bvksound/UPL_AudioAnalyzer/KEYBOARD/BOM/BOM KeyBoard.xlsx

Part | Supplier | Amount | Unit price | Total (Unit Price) | Description
N/A | JLCPCB | 1 |  | 0 | PCB
evq-q2b01w (https://be.farnell.com/panasonic/evq-q2b01w/switch-tactile-spst-20ma-15vdc/dp/2284612?ost=evq-q2b01w) | RSComponents | 50 | 0.316 | 15.8 | Button
538-52044-3445 (https://www.mouser.be/ProductDetail/538-52044-3445) | Mouser | 1 | 2.84 | 2.84 | 34Pin FPC Connector
FPC Cable 34Pin (https://nl.aliexpress.com/item/4000218028794.html?spm=a2g0s.9042311.0.0.27424c4dXkaReW) | Aliexpress | 1 | 2.91 | 2.91 | 34Pin FPC Cable pitch 1.25mm
Generic | Farnell | 6 | 0.05 | 0.3 | LED 1206
 |  |  | Euro | 21.85
