bvksound/UPL_AudioAnalyzer/KEYBOARD/CAD/Buttons.dxf

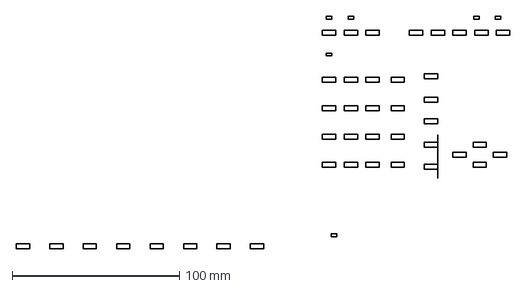
[picture p1: CAD file, 2020-04-19]
KEYBOARD/CAD/Buttons.dxf
295.0 x 138.8 mm
