bvksound/UPL_AudioAnalyzer/KEYBOARD/CAD/Outline.dxf

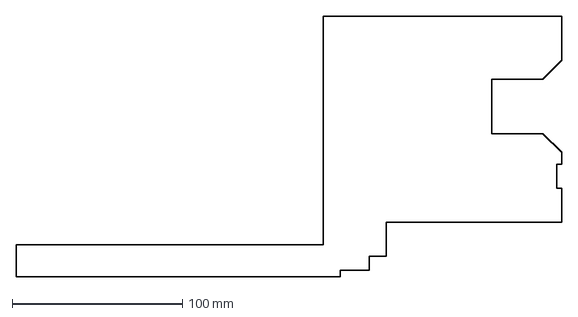
[picture p2: CAD file, 2020-04-19]
KEYBOARD/CAD/Outline.dxf
320.0 x 153.0 mm
