bvksound/UPL_AudioAnalyzer/KEYBOARD/CAD/Holes.dxf

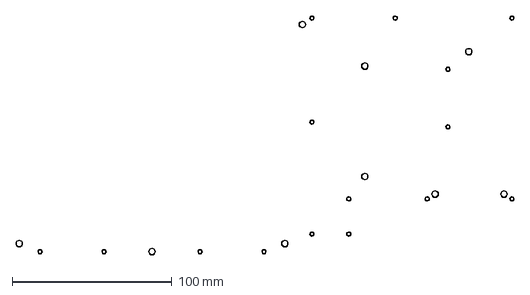
[picture p3: CAD file, 2020-04-19]
KEYBOARD/CAD/Holes.dxf
311.2 x 149.2 mm
