bvksound/UPL_AudioAnalyzer/(list of files, cad)

Other CAD files:
ISA INTERCONNECT/CAD/ISA Interconnect v3.dxf
KEYBOARD/CAD/R&S UPL KeyBoard BackPanel.f3d
