bvksound/UPL_AudioAnalyzer/KEYBOARD/PCB/SMD Buttons/UPL_Keyboard_Schematic.pdf

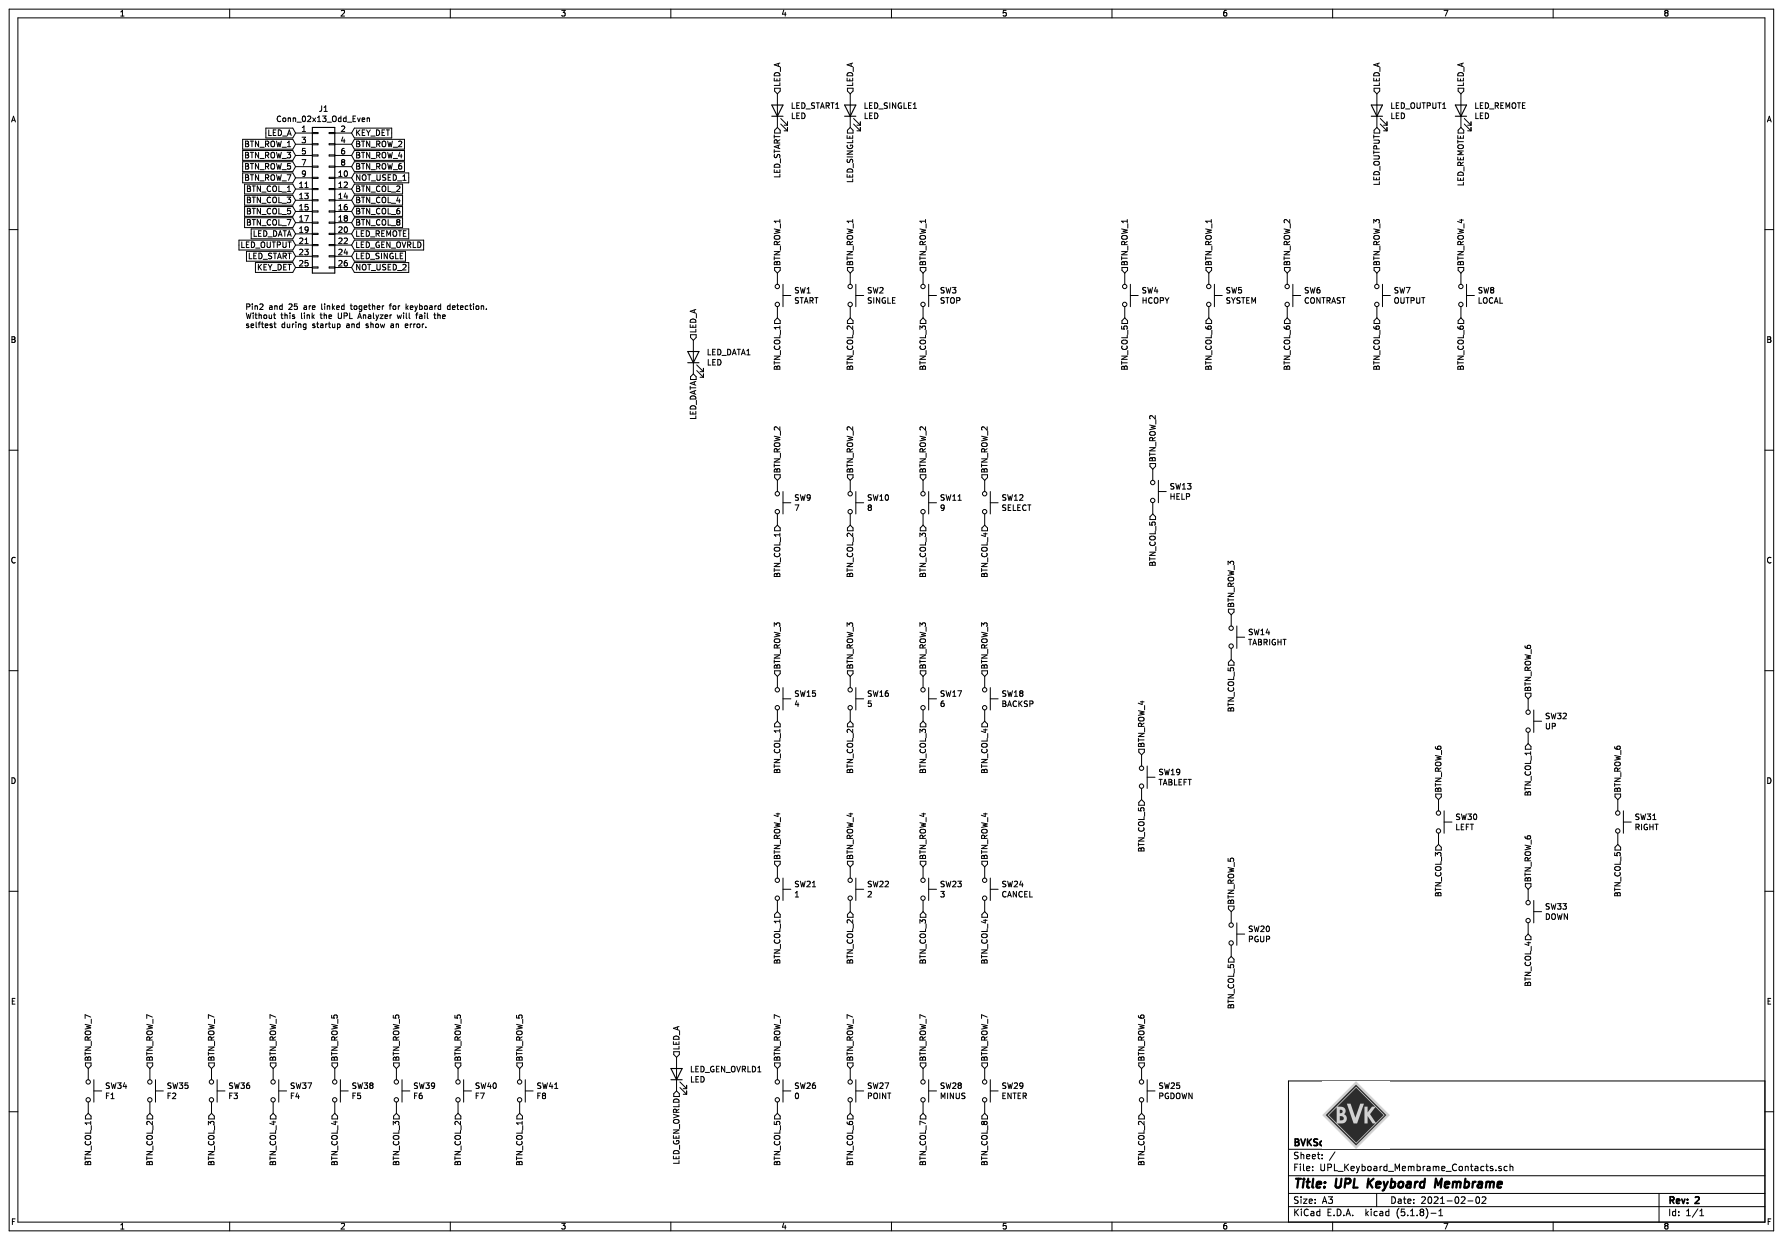
[picture p4: page 1]
