bvksound/UPL_AudioAnalyzer/PCB/keyboard.pdf

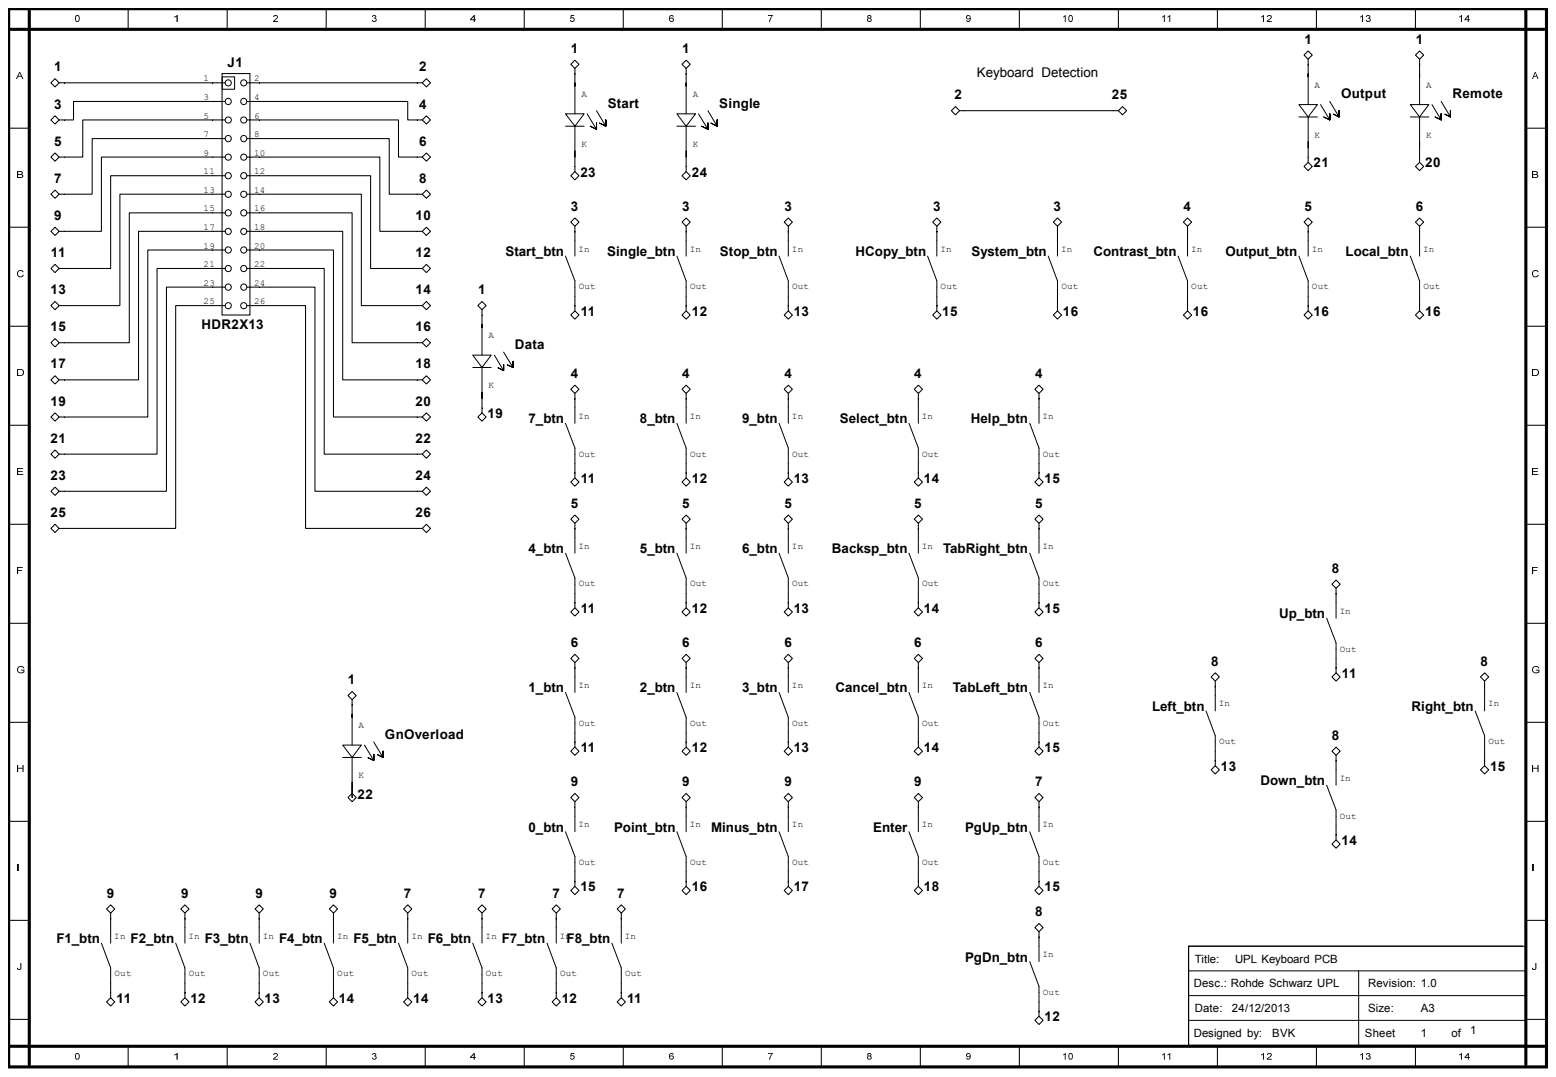
[picture p5: page 1]
HDR2X13; Data; System_btn; Out; Remote; Output; GnOverload; Start; Single; HCopy_btn; Stop_btn; Single_btn; Start_btn; Contrast_btn; Help_btn; Select_btn; 9_btn; 8_btn; 7_btn; Output_btn; TabRight_btn; Backsp_btn; 6_btn; 5_btn; 4_btn; Local_btn; TabLeft_btn; Cancel_btn; 3_btn; 2_btn; 1_btn; PgUp_btn; F8_btn; F7_btn; F6_btn; F5_btn; PgDn_btn; Keyboard Detection; Enter; Minus_btn; Point_btn; 0_btn; Up_btn; Down_btn; Left_btn; Right_btn; F1_btn; F2_btn; F3_btn; F4_btn; Title:; Designed by:; Sheet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

UPL Keyboard PCB

Desc.: Rohde Schwarz UPL | Revision: 1.0

Date: 24/12/2013 | Size: A3
