bvksound/UPL_AudioAnalyzer/PCB/Ultiboard.pdf

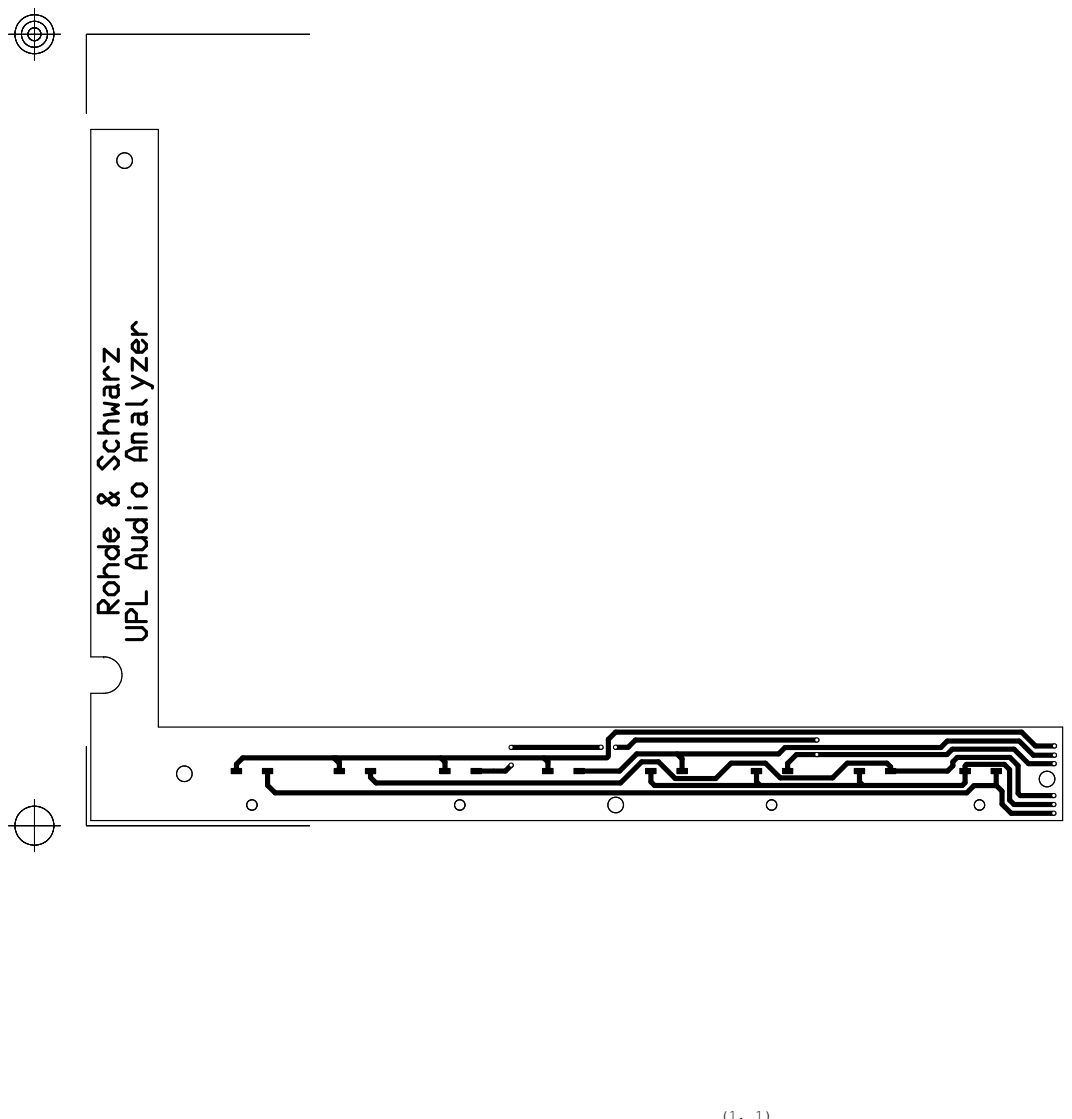
[picture p6: page 1]

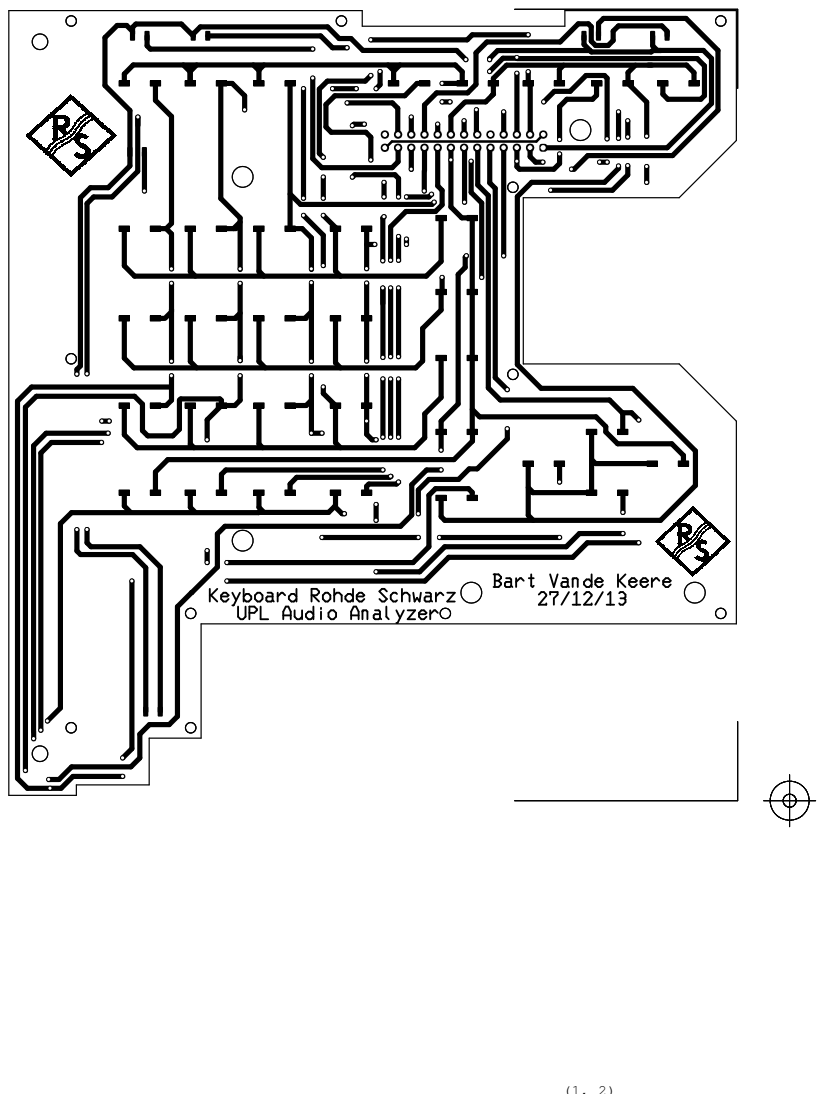
[picture p7: page 2]
