bvksound/UPL_AudioAnalyzer/KEYBOARD/PCB/SMD Buttons/UPL_KeyBoard_Eagle.pdf

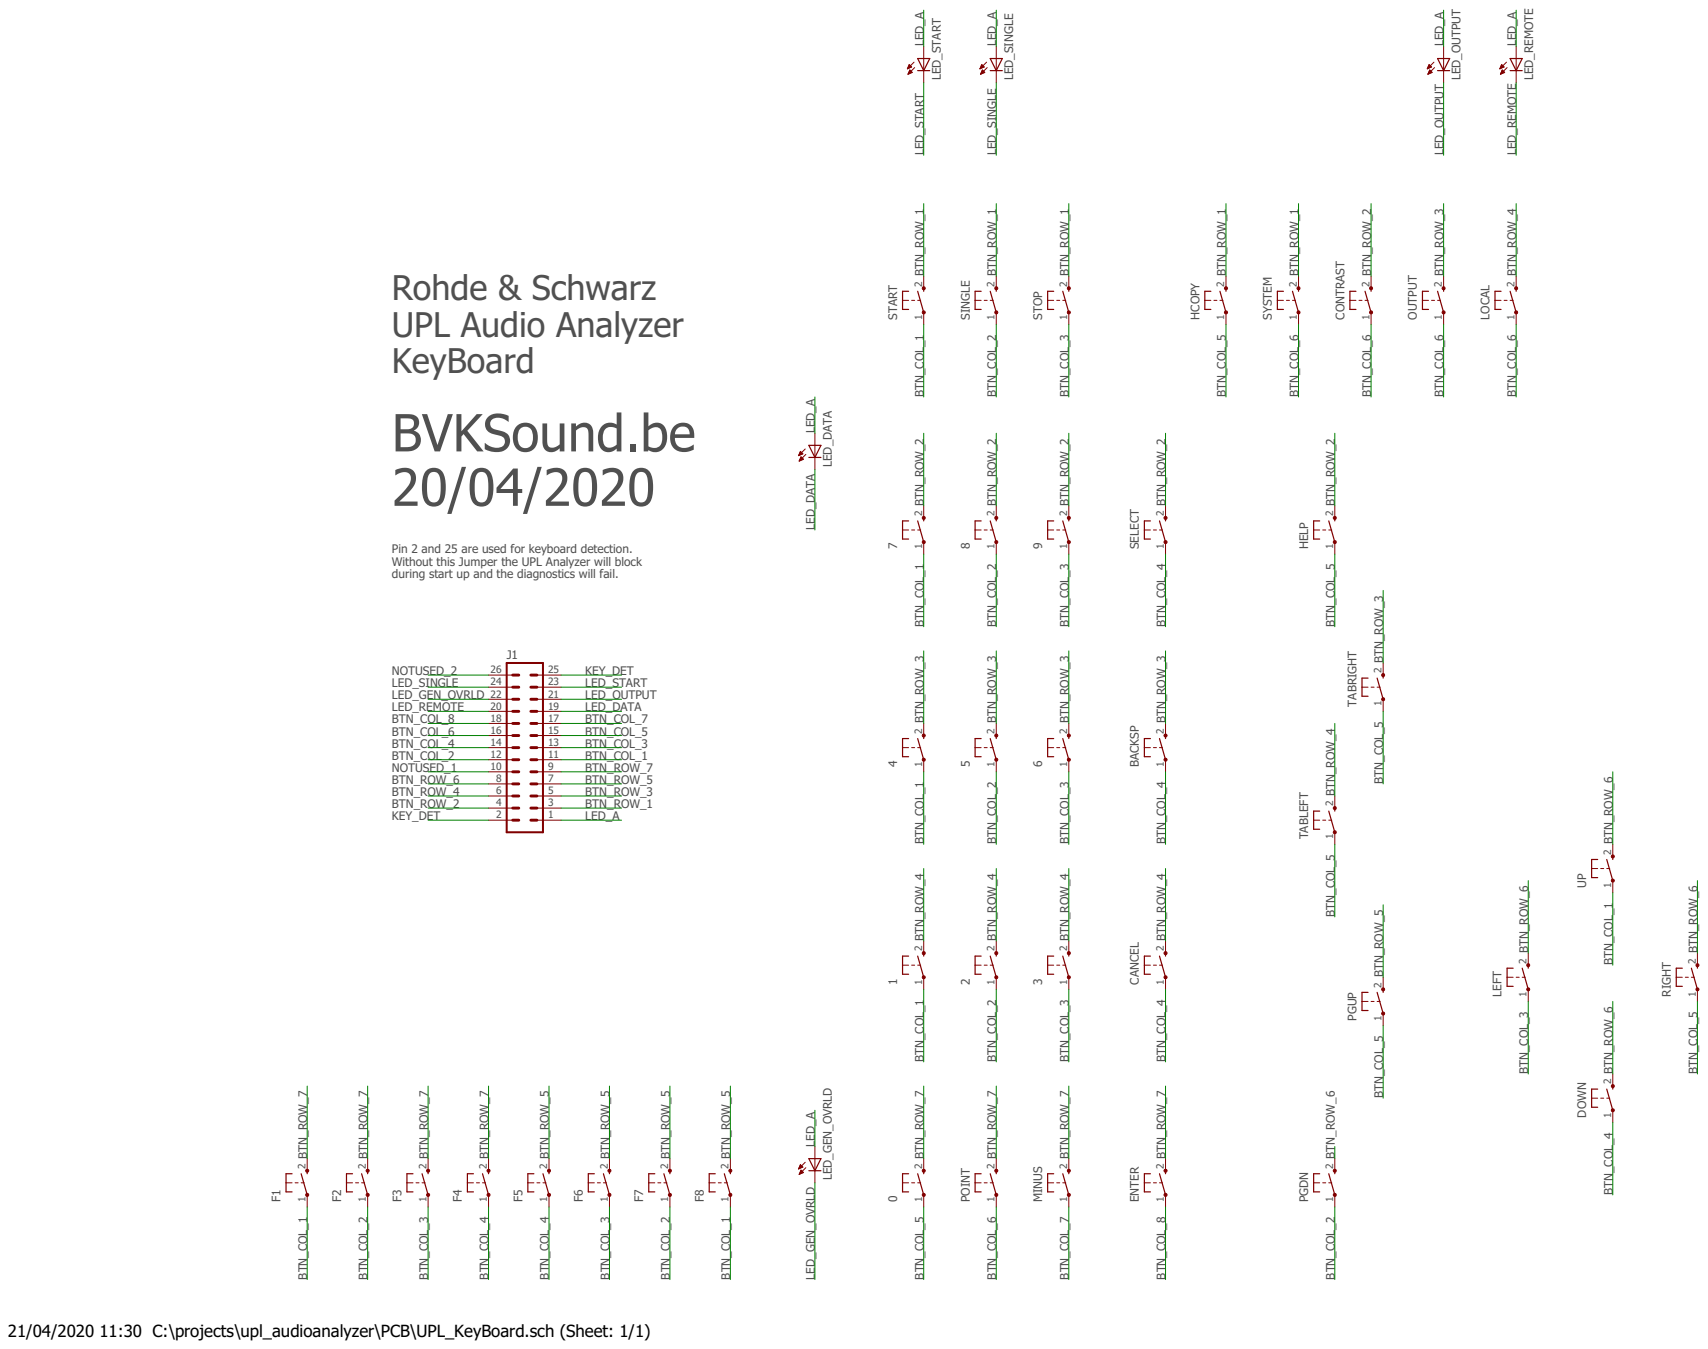
[picture p8: page 1]
