bvksound/UPL_AudioAnalyzer/KEYBOARD/PCB/SMD Buttons/UPL_Keyboard.kicad_pcb

## KiCad design KEYBOARD/PCB/SMD Buttons/UPL_Keyboard.kicad_pcb (2021-11-21)

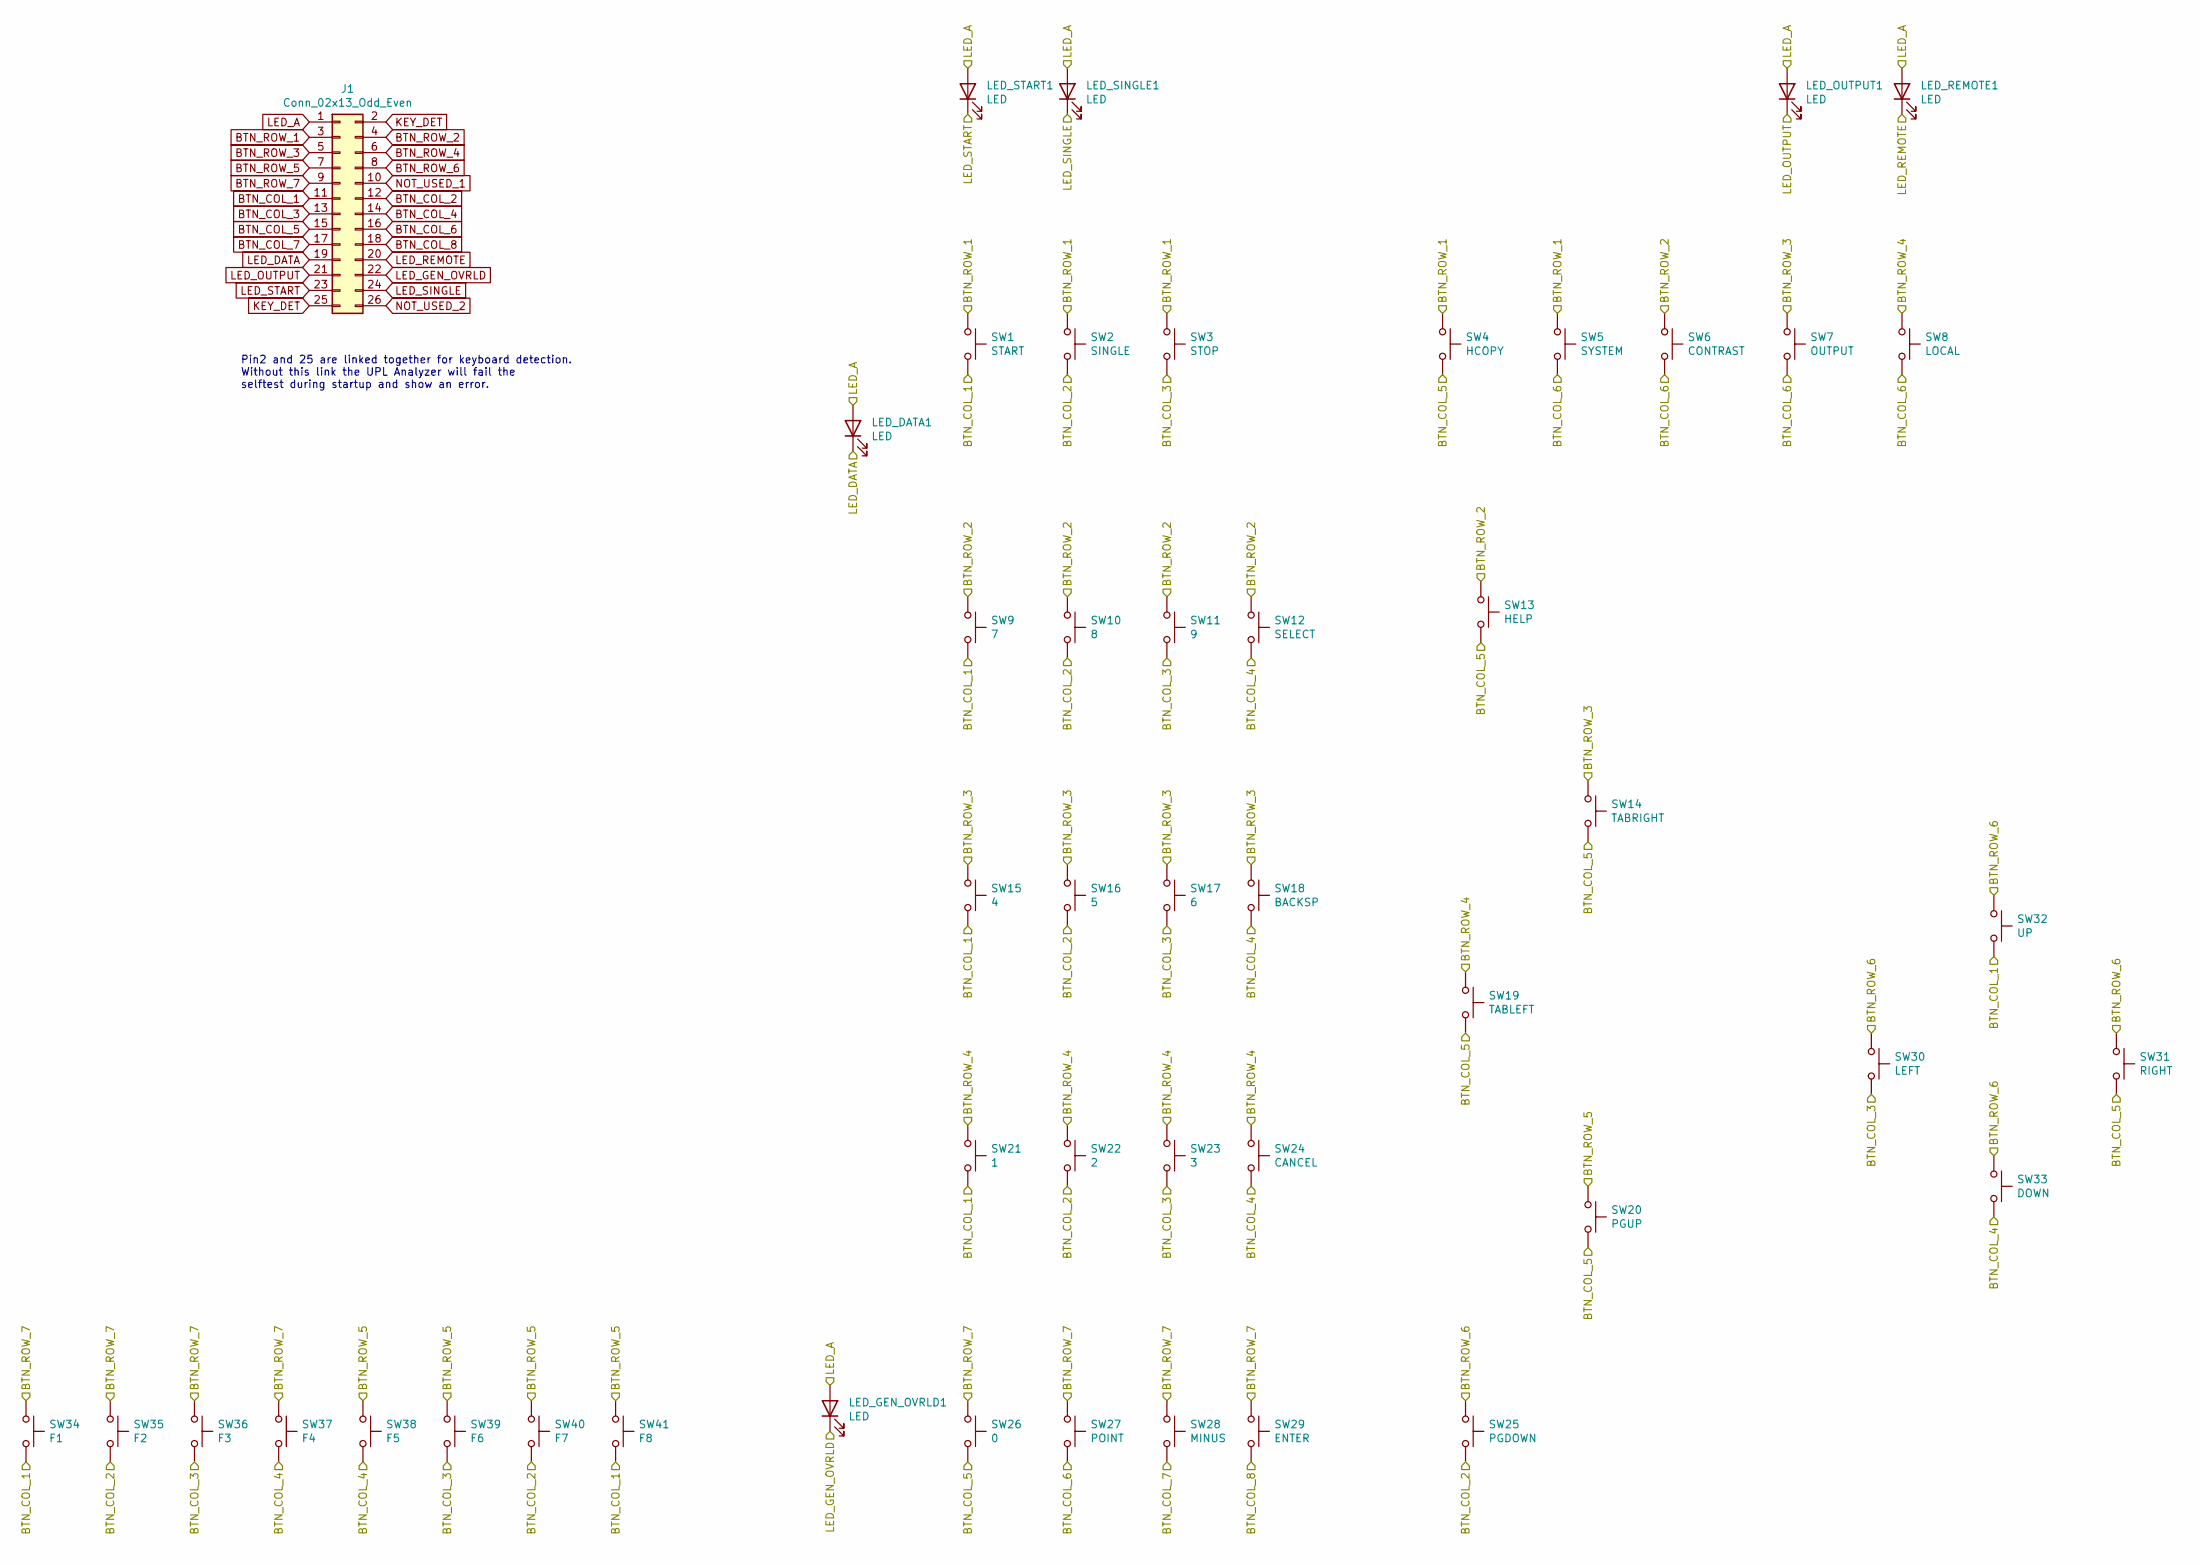
[picture p9: schematic UPL_KeyBoard.sch, UPL Keyboard Membrame]

Parts:
J1: Conn_02x13_Odd_Even; 0520443445_Mirrored
LED_DATA1: LED; LED_1206_3216Metric
LED_GEN_OVRLD1: LED; LED_1206_3216Metric
LED_OUTPUT1: LED; LED_1206_3216Metric
LED_REMOTE1: LED; LED_1206_3216Metric
LED_SINGLE1: LED; LED_1206_3216Metric
LED_START1: LED; LED_1206_3216Metric
SW1: START; EVQ-Q2B01W
SW2: SINGLE; EVQ-Q2B01W
SW3: STOP; EVQ-Q2B01W
SW4: HCOPY; EVQ-Q2B01W
SW5: SYSTEM; EVQ-Q2B01W
SW6: CONTRAST; EVQ-Q2B01W
SW7: OUTPUT; EVQ-Q2B01W
SW8: LOCAL; EVQ-Q2B01W
SW9: 7; EVQ-Q2B01W
SW10: 8; EVQ-Q2B01W
SW11: 9; EVQ-Q2B01W
SW12: SELECT; EVQ-Q2B01W
SW13: HELP; EVQ-Q2B01W
SW14: TABRIGHT; EVQ-Q2B01W
SW15: 4; EVQ-Q2B01W
SW16: 5; EVQ-Q2B01W
SW17: 6; EVQ-Q2B01W
SW18: BACKSP; EVQ-Q2B01W
SW19: TABLEFT; EVQ-Q2B01W
SW20: PGUP; EVQ-Q2B01W
SW21: 1; EVQ-Q2B01W
SW22: 2; EVQ-Q2B01W
SW23: 3; EVQ-Q2B01W
SW24: CANCEL; EVQ-Q2B01W
SW25: PGDOWN; EVQ-Q2B01W
SW26: 0; EVQ-Q2B01W
SW27: POINT; EVQ-Q2B01W
SW28: MINUS; EVQ-Q2B01W
SW29: ENTER; EVQ-Q2B01W
SW30: LEFT; EVQ-Q2B01W
SW31: RIGHT; EVQ-Q2B01W
SW32: UP; EVQ-Q2B01W
SW33: DOWN; EVQ-Q2B01W
SW34: F1; EVQ-Q2B01W
SW35: F2; EVQ-Q2B01W
SW36: F3; EVQ-Q2B01W
SW37: F4; EVQ-Q2B01W
SW38: F5; EVQ-Q2B01W
SW39: F6; EVQ-Q2B01W
SW40: F7; EVQ-Q2B01W
SW41: F8; EVQ-Q2B01W

Connections:
BTN_COL_1: J1.11, SW1.2, SW9.2, SW15.2, SW21.2, SW32.2, SW34.2, SW41.2
BTN_COL_2: J1.12, SW2.2, SW10.2, SW16.2, SW22.2, SW25.2, SW35.2, SW40.2
BTN_COL_3: J1.13, SW3.2, SW11.2, SW17.2, SW23.2, SW30.2, SW36.2, SW39.2
BTN_COL_4: J1.14, SW12.2, SW18.2, SW24.2, SW33.2, SW37.2, SW38.2
BTN_COL_5: J1.15, SW4.2, SW13.2, SW14.2, SW19.2, SW20.2, SW26.2, SW31.2
BTN_COL_6: J1.16, SW5.2, SW6.2, SW7.2, SW8.2, SW27.2
BTN_COL_7: J1.17, SW28.2
BTN_COL_8: J1.18, SW29.2
BTN_ROW_1: J1.3, SW1.1, SW2.1, SW3.1, SW4.1, SW5.1
BTN_ROW_2: J1.4, SW6.1, SW9.1, SW10.1, SW11.1, SW12.1, SW13.1
BTN_ROW_3: J1.5, SW7.1, SW14.1, SW15.1, SW16.1, SW17.1, SW18.1
BTN_ROW_4: J1.6, SW8.1, SW19.1, SW21.1, SW22.1, SW23.1, SW24.1
BTN_ROW_5: J1.7, SW20.1, SW38.1, SW39.1, SW40.1, SW41.1
BTN_ROW_6: J1.8, SW25.1, SW30.1, SW31.1, SW32.1, SW33.1
BTN_ROW_7: J1.9, SW26.1, SW27.1, SW28.1, SW29.1, SW34.1, SW35.1, SW36.1, SW37.1
KEY_DET: J1.2, J1.25
LED_A: J1.1, LED_DATA1.2 (A), LED_GEN_OVRLD1.2 (A), LED_OUTPUT1.2 (A), LED_REMOTE1.2 (A), LED_SINGLE1.2 (A), LED_START1.2 (A)
LED_DATA: J1.19, LED_DATA1.1 (K)
LED_GEN_OVRLD: J1.22, LED_GEN_OVRLD1.1 (K)
LED_OUTPUT: J1.21, LED_OUTPUT1.1 (K)
LED_REMOTE: J1.20, LED_REMOTE1.1 (K)
LED_SINGLE: J1.24, LED_SINGLE1.1 (K)
LED_START: J1.23, LED_START1.1 (K)
NOT_USED_1: J1.10
NOT_USED_2: J1.26

Notes on the sheet:
Pin2 and 25 are linked together for keyboard detection. Without this link the UPL Analyzer will fail the selftest during startup and show an error.

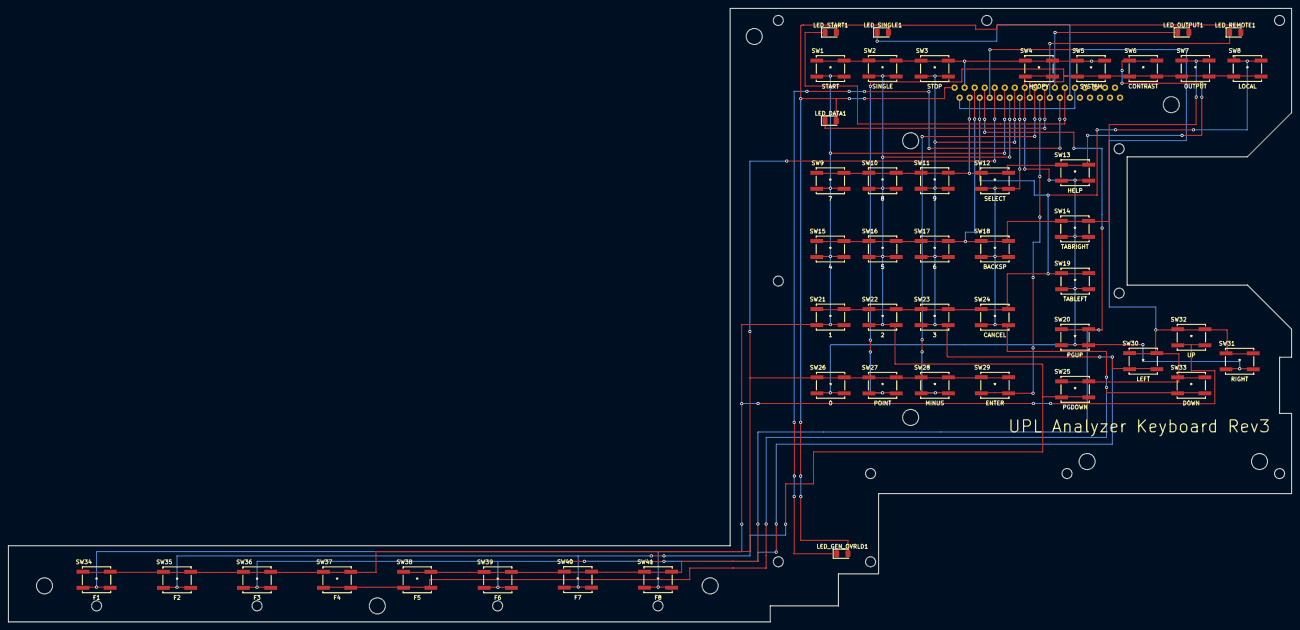
[picture p10: board UPL_Keyboard.kicad_pcb from above]

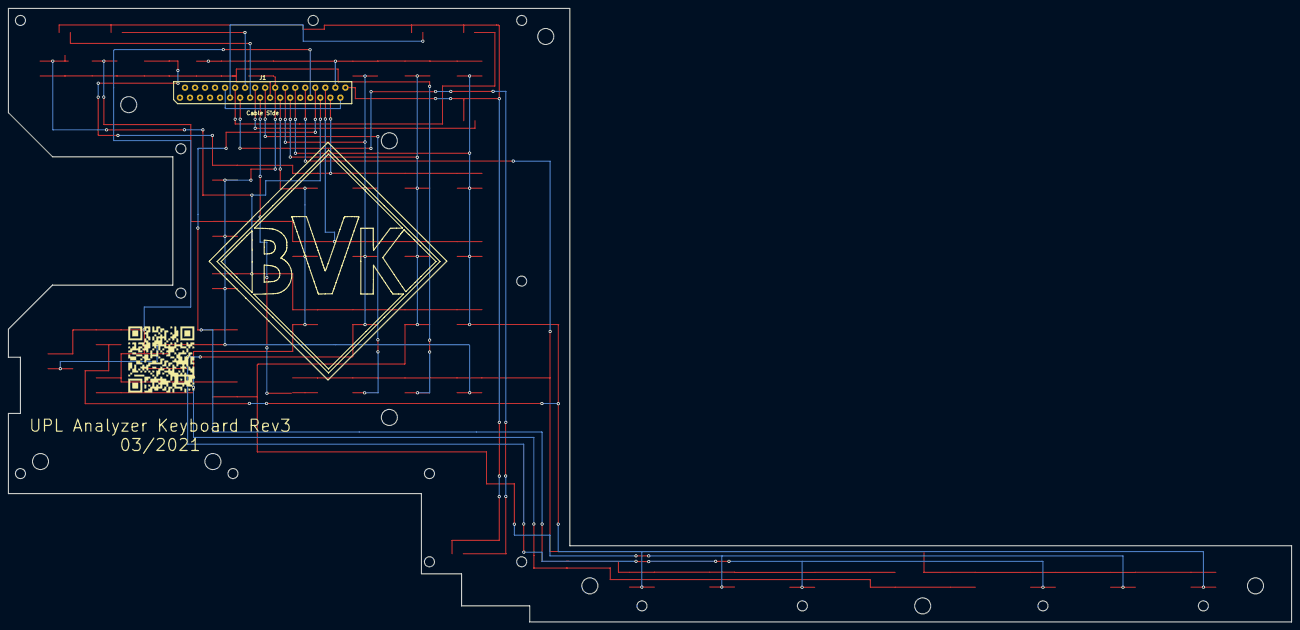
[picture p11: board UPL_Keyboard.kicad_pcb from below]

Board: 2 copper layers, 320.0 x 153.0 mm, 49 parts (2 on the bottom side), 23 nets.

Other parts of the board:
QR*****: www.bvksound.be
