bvksound/UPL_AudioAnalyzer/(commit log)

2020-04-14 draft added
    [Left outline.dxf, Left.dxf, Right outline.dxf, Right.dxf, keyboard.ms12]
2020-04-19 Keyboard shortcuts added
    [Keyboard Shortcuts.xlsx]
2020-04-19 Updated design of fusion 360, also backupped in the cloud of autodesk
    [Left outline.dxf, Left.dxf, R&S UPL KeyBoard BackPanel.f3d, Right outline.dxf, Right.dxf]
2020-04-19 schematic done
    [Buttons.dxf, Holes.dxf, Outline.dxf, UPL_KeyBoard.brd, UPL_KeyBoard.sch, keyboard.ms12]
2020-04-20 first draft of pcb design, bom added, gerber configuration added
    [BOM KeyBoard.xlsx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]
2020-04-20 final design added
    [UPL_KeyBoard.brd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]
2020-04-28 Removed trailing trace, final design, Freeze
    [UPL_KeyBoard.brd, UPL_KeyBoard.sch]
2020-05-05 updated with remaining components
    [BOM KeyBoard.xlsx]
2021-01-23 ISA Board Added
    Reorganised + added first revision of ISA Interconnect board
    [BOM KeyBoard.xlsx, Buttons.dxf, Holes.dxf, ISA Interconnect v3.dxf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]
2021-02-03 Membrame version draft schematic added
    [UPL_KeyBoard.brd, UPL_KeyBoard.sch, UPL_Keyboard_Membrame_Contacts.kicad_pcb, UPL_Keyboard_Membrame_Contacts.sch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]
2021-02-13 Kicad Rev2
    Kicad design added based on new smaller ALPS buttons
    [UPL_KeyBoard.brd, UPL_KeyBoard.sch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]
2021-02-13 cleanup pcb
    cleanup move connector for more clearance screw
    [UPL_Keyboard-B_Cu.gbr, UPL_Keyboard-B_Mask.gbr, UPL_Keyboard-B_Paste.gbr, UPL_Keyboard-B_SilkS.gbr, UPL_Keyboard-Edge_Cuts.gbr, UPL_Keyboard-F_Cu.gbr, UPL_Keyboard-F_Mask.gbr, UPL_Keyboard-F_Paste.gbr]
2021-03-18 Update of SMD button manufacturer
    Change SMD buttons to EVQQ2P02W
    [UPL_Keyboard.kicad_pcb]
2021-03-20 Finalized design with FFC Connector
    [UPL_KeyBoard.sch, UPL_Keyboard.kicad_pcb]
2021-03-26 final update rev3
    [UPL_Keyboard-B_Cu.gbr, UPL_Keyboard-B_Mask.gbr, UPL_Keyboard-B_Paste.gbr, UPL_Keyboard-B_SilkS.gbr, UPL_Keyboard-Edge_Cuts.gbr, UPL_Keyboard-F_Cu.gbr, UPL_Keyboard-F_Mask.gbr, UPL_Keyboard-F_Paste.gbr]
2021-11-21 Rev3 updated Bom
    update outdated BOM
    [BOM KeyBoard.xlsx, UPL_KeyBoard.sch, UPL_Keyboard.kicad_pcb]
